mcquerol/24ghz-imp165-speed-measurement/PCB/speed_sensor.kicad_pcb

## KiCad design PCB/speed_sensor.kicad_pcb (2023-01-03)

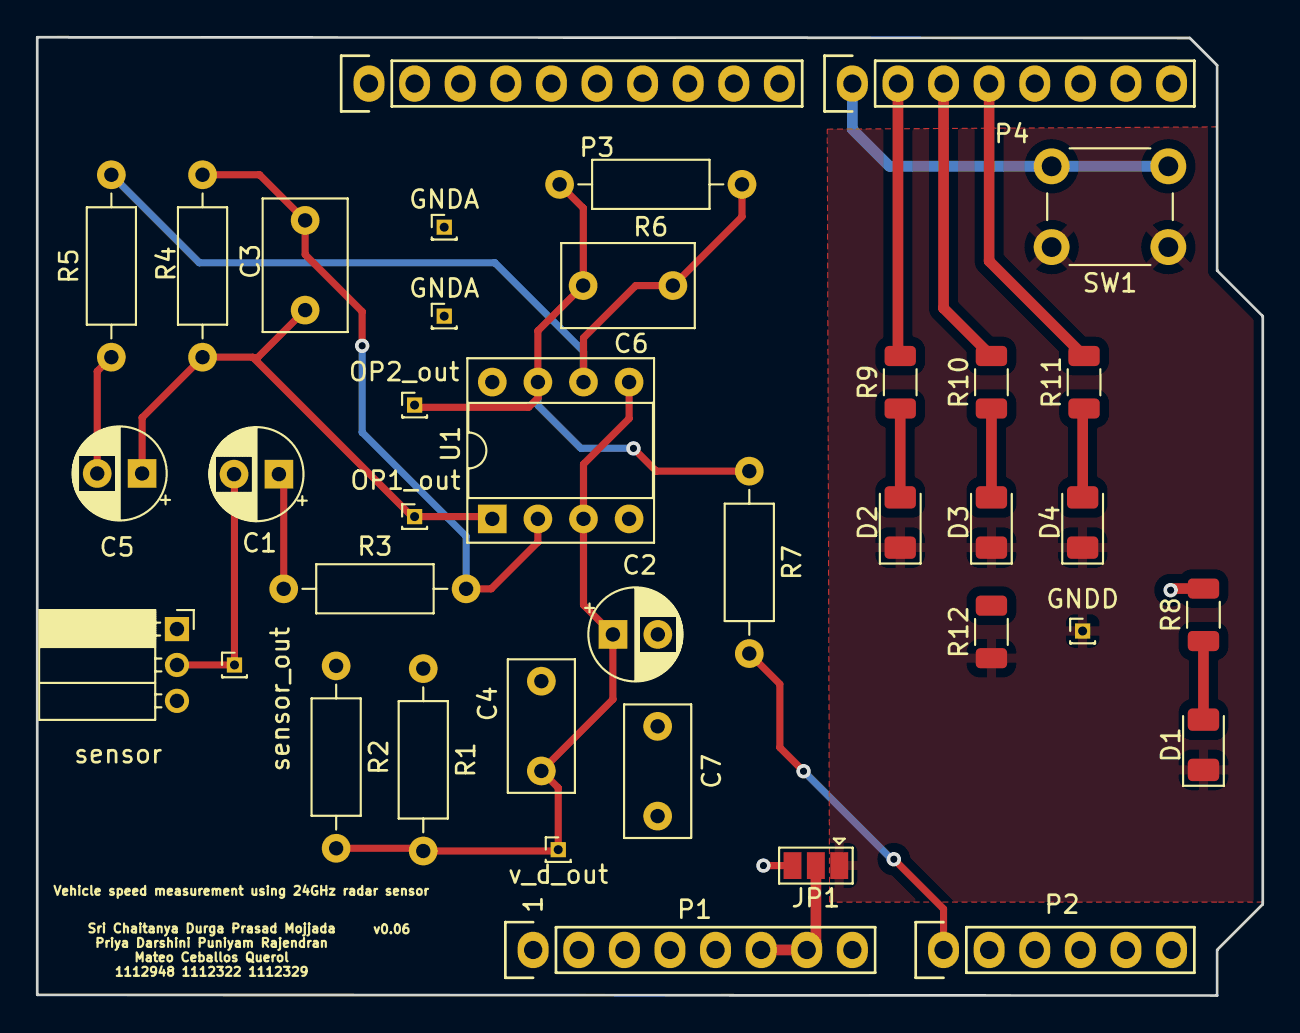
[picture p6: board speed_sensor.kicad_pcb from above]

Board: 4 copper layers, 68.3 x 53.4 mm, 38 parts (0 on the bottom side), 21 nets.

Parts:
C1, C5: 4.7u; CP_Radial_D5.0mm_P2.50mm
C2: 22u; CP_Radial_D5.0mm_P2.50mm
C3: 1.5n; C_Rect_L7.2mm_W4.5mm_P5.00mm_FKS2_FKP2_MKS2_MKP2
C4, C7: 100n; C_Rect_L7.2mm_W3.5mm_P5.00mm_FKS2_FKP2_MKS2_MKP2
C6: 3.3n; C_Rect_L7.2mm_W4.5mm_P5.00mm_FKS2_FKP2_MKS2_MKP2
D1, D2: Red LED; LED_1206_3216Metric
D3: Yellow LED; LED_1206_3216Metric
D4: Green LED; LED_1206_3216Metric
GNDA: GNDA; PinHeader_1x01_P1.00mm_Vertical
GNDA#2: GNDA; PinHeader_1x01_P1.00mm_Vertical
GNDD: GNDD; PinHeader_1x01_P1.00mm_Vertical
JP1: SolderJumper; SolderJumper-3_P1.3mm_Open_Pad1.0x1.5mm
OP1_out: OP1_output; PinHeader_1x01_P1.00mm_Vertical
OP2_out: OP2_output; PinHeader_1x01_P1.00mm_Vertical
P1: Power; Socket_Strip_Arduino_1x08
P2: Analog; Socket_Strip_Arduino_1x06
P3: Digital; Socket_Strip_Arduino_1x10
P4: Digital; Socket_Strip_Arduino_1x08
R1, R2: 1k; R_Axial_DIN0207_L6.3mm_D2.5mm_P10.16mm_Horizontal
R3: 2.2k; R_Axial_DIN0207_L6.3mm_D2.5mm_P10.16mm_Horizontal
R4: 220k; R_Axial_DIN0207_L6.3mm_D2.5mm_P10.16mm_Horizontal
R5: 33k; R_Axial_DIN0207_L6.3mm_D2.5mm_P10.16mm_Horizontal
R6: 100k; R_Axial_DIN0207_L6.3mm_D2.5mm_P10.16mm_Horizontal
R7: 100; R_Axial_DIN0207_L6.3mm_D2.5mm_P10.16mm_Horizontal
R8, R9, R10, R11: 470; R_1206_3216Metric
R12: 10k; R_1206_3216Metric
SW1: SW_Push; SW_PUSH_6mm_H5mm
U1: LMV358; DIP-8_W7.62mm_Socket
sensor: data; PinSocket_1x03_P2.00mm_Horizontal
sensor_out: sensor_output; PinHeader_1x01_P1.00mm_Vertical
v_d_out: v_d_out; PinHeader_1x01_P1.00mm_Vertical

Connections:
+5V: C7.2, P1.5, R1.1, R8.2, U1.8 (V+), sensor.3
/A0: P2.1, R7.2
/D4: P4.4, R11.2
/D5: P4.3, R10.2
/D6: P4.2, R9.2
/D7: P4.1, SW1.2
/V_IN: C1.2, sensor.2, sensor_out.1
/v_cm: C2.1, C4.1, R1.2, R2.2, U1.3 (+), U1.5 (+), v_d_out.1
GND: JP1.2 (C), P1.6, P1.7
GNDA: C2.2, C4.2, C7.1, GNDA.1, GNDA#2.1, JP1.3 (B), R2.1, U1.4 (V-), sensor.1
GNDD: D1.1 (K), D2.1 (K), D3.1 (K), D4.1 (K), GNDD.1, JP1.1 (A), R12.1, SW1.1
unnamed: C1.1, R3.1
unnamed: C3.1, R3.2, R4.1, U1.2 (-)
unnamed: C3.2, C5.1, OP1_out.1, R4.2, U1.1
unnamed: C5.2, R5.1
unnamed: C6.1, R5.2, R6.1, U1.6 (-)
unnamed: C6.2, OP2_out.1, R6.2, R7.1, U1.7
unnamed: D1.2 (A), R8.1
unnamed: D2.2 (A), R9.1
unnamed: D3.2 (A), R10.1
unnamed: D4.2 (A), R11.1
