mcquerol/24ghz-imp165-speed-measurement/CODE/speed_sensor.cydsn/codegentemp/ADC_in_aliases.h

/*******************************************************************************
* File Name: ADC_in.h  
* Version 2.20
*
* Description:
*  This file contains the Alias definitions for Per-Pin APIs in cypins.h. 
*  Information on using these APIs can be found in the System Reference Guide.
*
* Note:
*
********************************************************************************
* Copyright 2008-2015, Cypress Semiconductor Corporation.  All rights reserved.
* You may use this file only in accordance with the license, terms, conditions, 
* disclaimers, and limitations in the end user license agreement accompanying 
* the software package with which this file was provided.
*******************************************************************************/

#if !defined(CY_PINS_ADC_in_ALIASES_H) /* Pins ADC_in_ALIASES_H */
#define CY_PINS_ADC_in_ALIASES_H

#include "cytypes.h"
#include "cyfitter.h"


/***************************************
*              Constants        
***************************************/
#define ADC_in_0			(ADC_in__0__PC)
#define ADC_in_0_INTR	((uint16)((uint16)0x0001u << ADC_in__0__SHIFT))

#define ADC_in_INTR_ALL	 ((uint16)(ADC_in_0_INTR))

#endif /* End Pins ADC_in_ALIASES_H */


/* [] END OF FILE */
