mcquerol/24ghz-imp165-speed-measurement/CODE/speed_sensor.cydsn/codegentemp/isr_btn.h

/*******************************************************************************
* File Name: isr_btn.h
* Version 1.70
*
*  Description:
*   Provides the function definitions for the Interrupt Controller.
*
*
********************************************************************************
* Copyright 2008-2015, Cypress Semiconductor Corporation.  All rights reserved.
* You may use this file only in accordance with the license, terms, conditions, 
* disclaimers, and limitations in the end user license agreement accompanying 
* the software package with which this file was provided.
*******************************************************************************/
#if !defined(CY_ISR_isr_btn_H)
#define CY_ISR_isr_btn_H


#include <cytypes.h>
#include <cyfitter.h>

/* Interrupt Controller API. */
void isr_btn_Start(void);
void isr_btn_StartEx(cyisraddress address);
void isr_btn_Stop(void);

CY_ISR_PROTO(isr_btn_Interrupt);

void isr_btn_SetVector(cyisraddress address);
cyisraddress isr_btn_GetVector(void);

void isr_btn_SetPriority(uint8 priority);
uint8 isr_btn_GetPriority(void);

void isr_btn_Enable(void);
uint8 isr_btn_GetState(void);
void isr_btn_Disable(void);

void isr_btn_SetPending(void);
void isr_btn_ClearPending(void);


/* Interrupt Controller Constants */

/* Address of the INTC.VECT[x] register that contains the Address of the isr_btn ISR. */
#define isr_btn_INTC_VECTOR            ((reg32 *) isr_btn__INTC_VECT)

/* Address of the isr_btn ISR priority. */
#define isr_btn_INTC_PRIOR             ((reg8 *) isr_btn__INTC_PRIOR_REG)

/* Priority of the isr_btn interrupt. */
#define isr_btn_INTC_PRIOR_NUMBER      isr_btn__INTC_PRIOR_NUM

/* Address of the INTC.SET_EN[x] byte to bit enable isr_btn interrupt. */
#define isr_btn_INTC_SET_EN            ((reg32 *) isr_btn__INTC_SET_EN_REG)

/* Address of the INTC.CLR_EN[x] register to bit clear the isr_btn interrupt. */
#define isr_btn_INTC_CLR_EN            ((reg32 *) isr_btn__INTC_CLR_EN_REG)

/* Address of the INTC.SET_PD[x] register to set the isr_btn interrupt state to pending. */
#define isr_btn_INTC_SET_PD            ((reg32 *) isr_btn__INTC_SET_PD_REG)

/* Address of the INTC.CLR_PD[x] register to clear the isr_btn interrupt. */
#define isr_btn_INTC_CLR_PD            ((reg32 *) isr_btn__INTC_CLR_PD_REG)


#endif /* CY_ISR_isr_btn_H */


/* [] END OF FILE */
