mcquerol/24ghz-imp165-speed-measurement/CODE/speed_sensor.cydsn/codegentemp/Btn_startSample.h

/*******************************************************************************
* File Name: Btn_startSample.h  
* Version 2.20
*
* Description:
*  This file contains Pin function prototypes and register defines
*
* Note:
*
********************************************************************************
* Copyright 2008-2015, Cypress Semiconductor Corporation.  All rights reserved.
* You may use this file only in accordance with the license, terms, conditions, 
* disclaimers, and limitations in the end user license agreement accompanying 
* the software package with which this file was provided.
*******************************************************************************/

#if !defined(CY_PINS_Btn_startSample_H) /* Pins Btn_startSample_H */
#define CY_PINS_Btn_startSample_H

#include "cytypes.h"
#include "cyfitter.h"
#include "cypins.h"
#include "Btn_startSample_aliases.h"

/* APIs are not generated for P15[7:6] */
#if !(CY_PSOC5A &&\
	 Btn_startSample__PORT == 15 && ((Btn_startSample__MASK & 0xC0) != 0))


/***************************************
*        Function Prototypes             
***************************************/    

/**
* \addtogroup group_general
* @{
*/
void    Btn_startSample_Write(uint8 value);
void    Btn_startSample_SetDriveMode(uint8 mode);
uint8   Btn_startSample_ReadDataReg(void);
uint8   Btn_startSample_Read(void);
void    Btn_startSample_SetInterruptMode(uint16 position, uint16 mode);
uint8   Btn_startSample_ClearInterrupt(void);
/** @} general */

/***************************************
*           API Constants        
***************************************/
/**
* \addtogroup group_constants
* @{
*/
    /** \addtogroup driveMode Drive mode constants
     * \brief Constants to be passed as "mode" parameter in the Btn_startSample_SetDriveMode() function.
     *  @{
     */
        #define Btn_startSample_DM_ALG_HIZ         PIN_DM_ALG_HIZ
        #define Btn_startSample_DM_DIG_HIZ         PIN_DM_DIG_HIZ
        #define Btn_startSample_DM_RES_UP          PIN_DM_RES_UP
        #define Btn_startSample_DM_RES_DWN         PIN_DM_RES_DWN
        #define Btn_startSample_DM_OD_LO           PIN_DM_OD_LO
        #define Btn_startSample_DM_OD_HI           PIN_DM_OD_HI
        #define Btn_startSample_DM_STRONG          PIN_DM_STRONG
        #define Btn_startSample_DM_RES_UPDWN       PIN_DM_RES_UPDWN
    /** @} driveMode */
/** @} group_constants */
    
/* Digital Port Constants */
#define Btn_startSample_MASK               Btn_startSample__MASK
#define Btn_startSample_SHIFT              Btn_startSample__SHIFT
#define Btn_startSample_WIDTH              1u

/* Interrupt constants */
#if defined(Btn_startSample__INTSTAT)
/**
* \addtogroup group_constants
* @{
*/
    /** \addtogroup intrMode Interrupt constants
     * \brief Constants to be passed as "mode" parameter in Btn_startSample_SetInterruptMode() function.
     *  @{
     */
        #define Btn_startSample_INTR_NONE      (uint16)(0x0000u)
        #define Btn_startSample_INTR_RISING    (uint16)(0x0001u)
        #define Btn_startSample_INTR_FALLING   (uint16)(0x0002u)
        #define Btn_startSample_INTR_BOTH      (uint16)(0x0003u) 
    /** @} intrMode */
/** @} group_constants */

    #define Btn_startSample_INTR_MASK      (0x01u) 
#endif /* (Btn_startSample__INTSTAT) */


/***************************************
*             Registers        
***************************************/

/* Main Port Registers */
/* Pin State */
#define Btn_startSample_PS                     (* (reg8 *) Btn_startSample__PS)
/* Data Register */
#define Btn_startSample_DR                     (* (reg8 *) Btn_startSample__DR)
/* Port Number */
#define Btn_startSample_PRT_NUM                (* (reg8 *) Btn_startSample__PRT) 
/* Connect to Analog Globals */                                                  
#define Btn_startSample_AG                     (* (reg8 *) Btn_startSample__AG)                       
/* Analog MUX bux enable */
#define Btn_startSample_AMUX                   (* (reg8 *) Btn_startSample__AMUX) 
/* Bidirectional Enable */                                                        
#define Btn_startSample_BIE                    (* (reg8 *) Btn_startSample__BIE)
/* Bit-mask for Aliased Register Access */
#define Btn_startSample_BIT_MASK               (* (reg8 *) Btn_startSample__BIT_MASK)
/* Bypass Enable */
#define Btn_startSample_BYP                    (* (reg8 *) Btn_startSample__BYP)
/* Port wide control signals */                                                   
#define Btn_startSample_CTL                    (* (reg8 *) Btn_startSample__CTL)
/* Drive Modes */
#define Btn_startSample_DM0                    (* (reg8 *) Btn_startSample__DM0) 
#define Btn_startSample_DM1                    (* (reg8 *) Btn_startSample__DM1)
#define Btn_startSample_DM2                    (* (reg8 *) Btn_startSample__DM2) 
/* Input Buffer Disable Override */
#define Btn_startSample_INP_DIS                (* (reg8 *) Btn_startSample__INP_DIS)
/* LCD Common or Segment Drive */
#define Btn_startSample_LCD_COM_SEG            (* (reg8 *) Btn_startSample__LCD_COM_SEG)
/* Enable Segment LCD */
#define Btn_startSample_LCD_EN                 (* (reg8 *) Btn_startSample__LCD_EN)
/* Slew Rate Control */
#define Btn_startSample_SLW                    (* (reg8 *) Btn_startSample__SLW)

/* DSI Port Registers */
/* Global DSI Select Register */
#define Btn_startSample_PRTDSI__CAPS_SEL       (* (reg8 *) Btn_startSample__PRTDSI__CAPS_SEL) 
/* Double Sync Enable */
#define Btn_startSample_PRTDSI__DBL_SYNC_IN    (* (reg8 *) Btn_startSample__PRTDSI__DBL_SYNC_IN) 
/* Output Enable Select Drive Strength */
#define Btn_startSample_PRTDSI__OE_SEL0        (* (reg8 *) Btn_startSample__PRTDSI__OE_SEL0) 
#define Btn_startSample_PRTDSI__OE_SEL1        (* (reg8 *) Btn_startSample__PRTDSI__OE_SEL1) 
/* Port Pin Output Select Registers */
#define Btn_startSample_PRTDSI__OUT_SEL0       (* (reg8 *) Btn_startSample__PRTDSI__OUT_SEL0) 
#define Btn_startSample_PRTDSI__OUT_SEL1       (* (reg8 *) Btn_startSample__PRTDSI__OUT_SEL1) 
/* Sync Output Enable Registers */
#define Btn_startSample_PRTDSI__SYNC_OUT       (* (reg8 *) Btn_startSample__PRTDSI__SYNC_OUT) 

/* SIO registers */
#if defined(Btn_startSample__SIO_CFG)
    #define Btn_startSample_SIO_HYST_EN        (* (reg8 *) Btn_startSample__SIO_HYST_EN)
    #define Btn_startSample_SIO_REG_HIFREQ     (* (reg8 *) Btn_startSample__SIO_REG_HIFREQ)
    #define Btn_startSample_SIO_CFG            (* (reg8 *) Btn_startSample__SIO_CFG)
    #define Btn_startSample_SIO_DIFF           (* (reg8 *) Btn_startSample__SIO_DIFF)
#endif /* (Btn_startSample__SIO_CFG) */

/* Interrupt Registers */
#if defined(Btn_startSample__INTSTAT)
    #define Btn_startSample_INTSTAT            (* (reg8 *) Btn_startSample__INTSTAT)
    #define Btn_startSample_SNAP               (* (reg8 *) Btn_startSample__SNAP)
    
	#define Btn_startSample_0_INTTYPE_REG 		(* (reg8 *) Btn_startSample__0__INTTYPE)
#endif /* (Btn_startSample__INTSTAT) */

#endif /* CY_PSOC5A... */

#endif /*  CY_PINS_Btn_startSample_H */


/* [] END OF FILE */
