mcquerol/24ghz-imp165-speed-measurement/(commit log)

2023-01-03 added PCB and its contents
    [speed_sensor-B_Cu.gbr, speed_sensor-B_Mask.gbr, speed_sensor-B_Paste.gbr, speed_sensor-B_Silkscreen.gbr, speed_sensor-Edge_Cuts.gbr, speed_sensor-F_Cu.gbr, speed_sensor-F_Mask.gbr, speed_sensor-F_Paste.gbr]
2023-07-31 added CODE and its contents
    [speed_sensor.sdf]
2026-04-07 Modify .gitattributes for KiCad file detection
    Updated KiCad file attributes to improve language detection.
2026-04-07 Update .gitattributes for KiCad file detection
2026-04-07 Modify KiCad file detection in .gitattributes
    Updated KiCad file detection settings in .gitattributes.
2026-04-07 Update .gitattributes for kicad_sym file detection
2026-04-07 Modify .gitattributes for KiCad file detection
    Updated .gitattributes to include and exclude specific KiCad files for GitHub detection.
2026-04-07 Update .gitattributes for KiCad file detection
    Changed linguist-detectable setting for .kicad_sch files.
2026-04-07 Modify .gitattributes for file detection improvements
    Updated .gitattributes to improve file detection settings for KiCad files and adjust generated source folder settings.
2026-04-07 Modify linguist detection for KiCad files
    Updated .gitattributes to change linguist detection settings for KiCad files.
2026-04-07 Modify KiCad file detection settings in .gitattributes
    Updated .gitattributes to change detection settings for KiCad files.
2026-04-07 Exclude KiCad auxiliary files from linguist stats
    Change KiCad auxiliary files to be excluded from stats.
2026-04-08 Update .gitattributes for assembly file detection
    Change assembly file handling to be detectable instead of vendored.
